burgrp/bleriot-relay/board/bleriot-relay.kicad_pcb

## KiCad design board/bleriot-relay.kicad_pcb (2026-11-08)

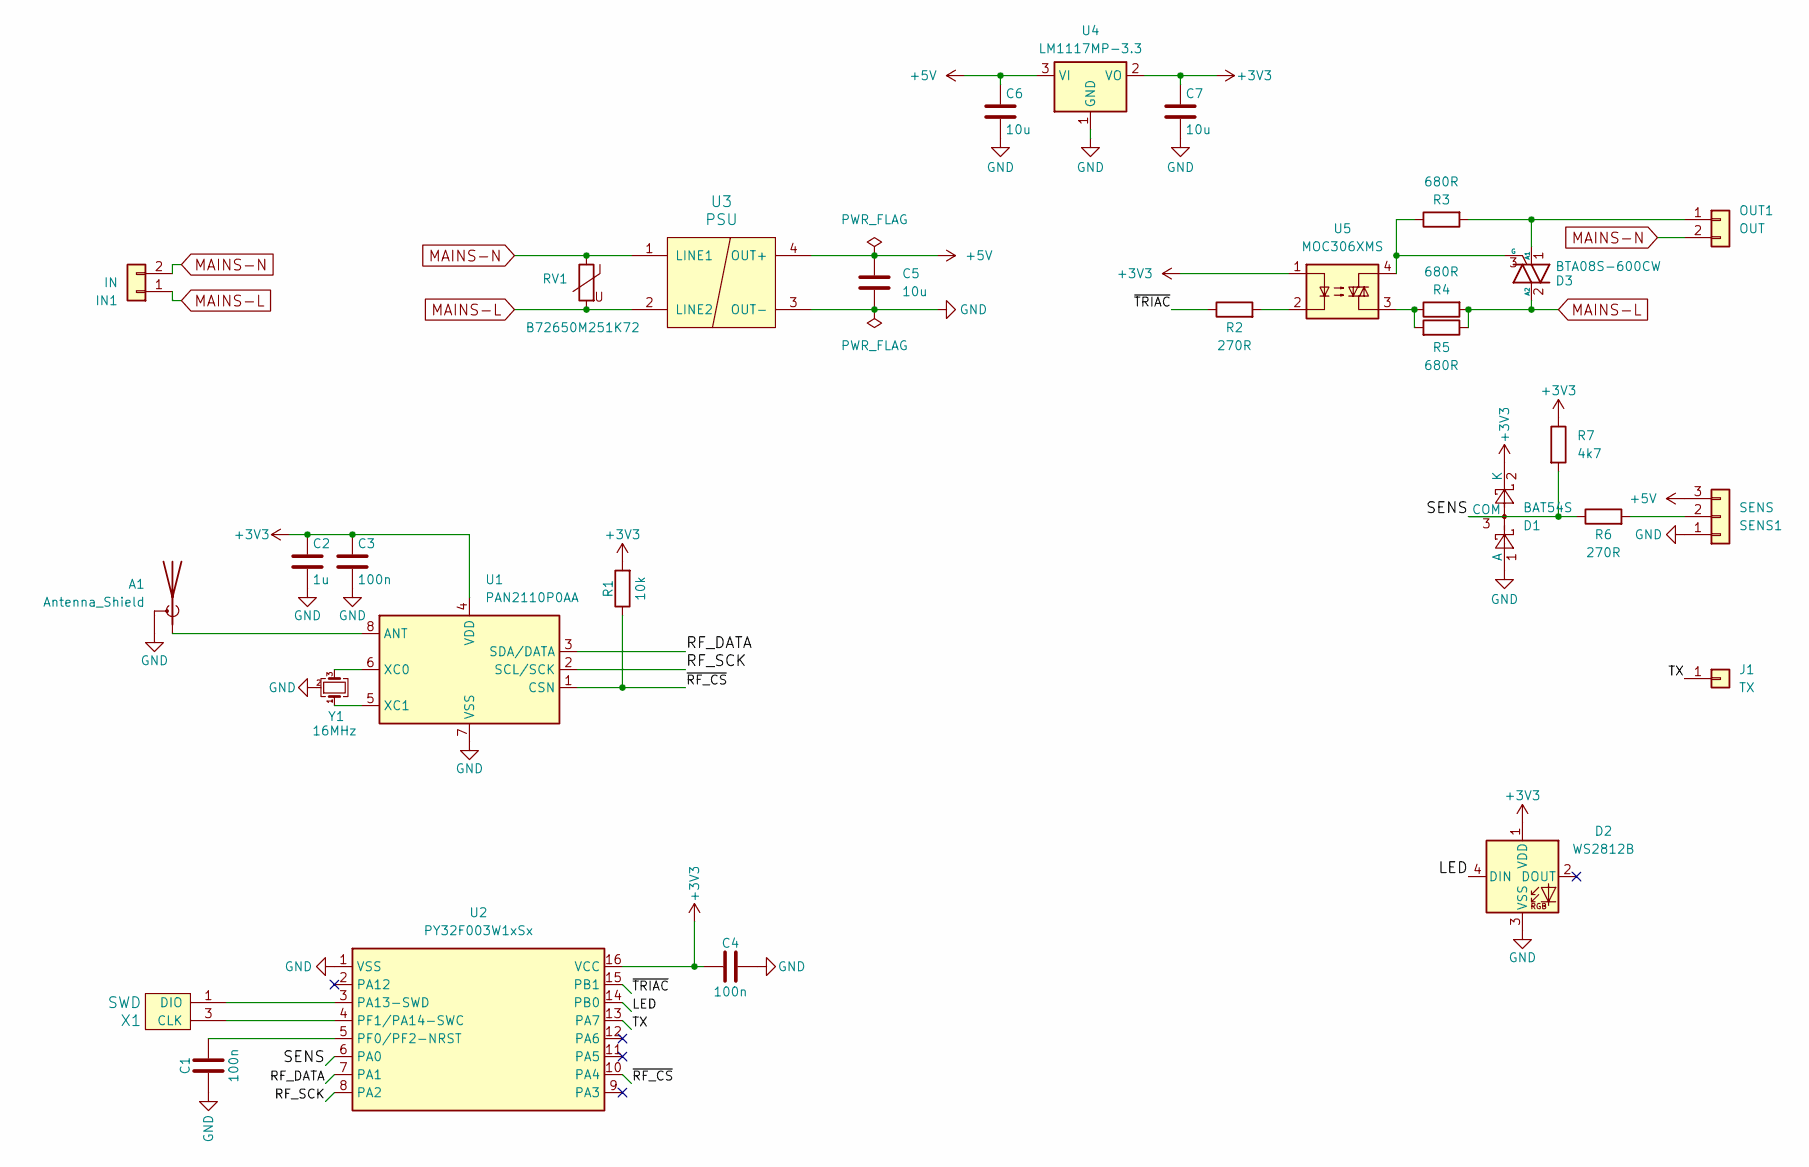
[picture p1: schematic bleriot-relay.kicad_sch]

Parts:
A1: Antenna_Shield; Texas_SWRA117D_2.4GHz_Right
C1, C3, C4: 100n; C_0805_2012Metric
C2: 1u; C_0805_2012Metric
C5, C6, C7: 10u; C_0805_2012Metric
D1: BAT54S; SOT-23
D2: WS2812B; LED_WS2812B_PLCC4_5.0x5.0mm_P3.2mm
D3: BTA08S-600CW; TO-252-2
IN1: IN; PhoenixContact_MSTBA_2,5_2-G_1x02_P5.00mm_Horizontal
J1: TX; PinHeader_1x01_P2.54mm_Vertical
OUT1: OUT; PhoenixContact_MSTBA_2,5_2-G_1x02_P5.00mm_Horizontal
R1: 10k; R_0805_2012Metric
R2, R6: 270R; R_0805_2012Metric
R3, R4, R5: 680R; R_0805_2012Metric
R7: 4k7; R_0805_2012Metric
RV1: B72650M251K72; R_1210_3225Metric
SENS1: SENS; PhoenixContact_MSTBA_2,5_3-G_1x03_P5.00mm_Horizontal
U1: PAN2110P0AA; SOIC-8_3.9x4.9mm_P1.27mm
U2: PY32F003W1xSx; SOIC-16_3.9x9.9mm_P1.27mm
U3: PSU; RQG 5V-0.6A-horizontal
U4: LM1117MP-3.3; SOT-223-3_TabPin2
U5: MOC306XMS; SMDIP-4_W7.62mm
X1: SWD
Y1: 16MHz; Crystal_SMD_3225-4Pin_3.2x2.5mm

Connections:
+3V3: C2.1, C3.1, C4.1, C7.1, D1.2 (K), D2.1 (VDD), R1.2, R7.1, U1.4 (VDD), U2.16 (VCC), U4.2 (VO), U5.1
+5V: C5.1, C6.1, SENS1.3, U3.4 (OUT+), U4.3 (VI)
/LED: D2.4 (DIN), U2.14 (PB0)
/RF_DATA: U1.3 (SDA/DATA), U2.7 (PA1)
/RF_SCK: U1.2 (SCL/SCK), U2.8 (PA2)
/SENS: D1.3 (COM), R6.1, R7.2, U2.6 (PA0)
/TX: J1.1 (Pin_1_1), U2.13 (PA7)
/~RF_CS: R1.1, U1.1 (CSN), U2.10 (PA4)
/~TRIAC: R2.1, U2.15 (PB1)
GND: A1.2 (Shield), C1.2, C2.2, C3.2, C4.2, C5.2, C6.2, C7.2, D1.1 (A), D2.3 (VSS), SENS1.1, U1.7 (VSS), U2.1 (VSS), U3.3 (OUT-), U4.1 (GND), X1.2 (GND), Y1.2 (G), Y1.4 (G)
MAINS-L: D3.2 (A2), IN1.1, R4.2, R5.1, RV1.2, U3.2 (LINE2)
MAINS-N: IN1.2, OUT1.2, RV1.1, U3.1 (LINE1)
unnamed: A1.1 (A), U1.8 (ANT)
unnamed: D3.1 (A1), OUT1.1, R3.2
unnamed: D3.3 (G), R3.1, U5.4
unnamed: R2.2, U5.2
unnamed: R4.1, R5.2, U5.3
unnamed: R6.2, SENS1.2
unnamed: U1.6 (XC0), Y1.3
unnamed: U1.5 (XC1), Y1.1
unnamed: U2.3 (PA13-SWD), X1.1 (DIO)
unnamed: C1.1, U2.5 (PF0/PF2-NRST)
unnamed: U2.4 (PF1/PA14-SWC), X1.3 (CLK)

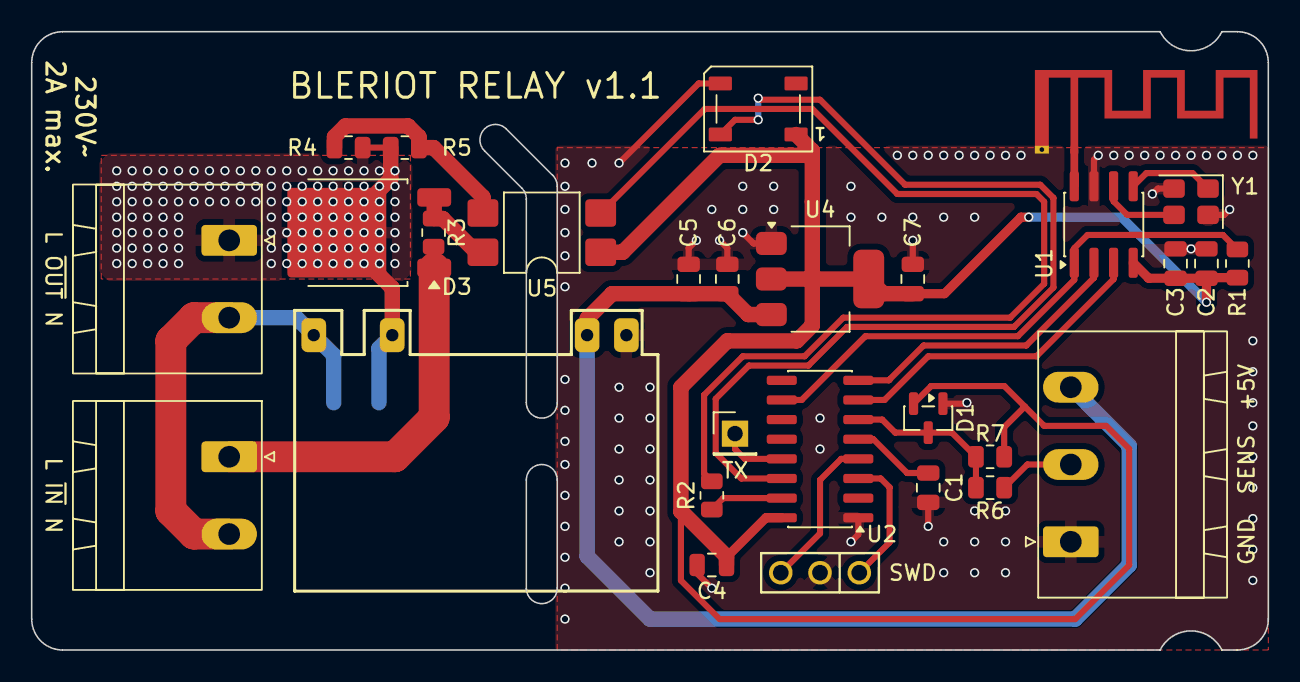
[picture p2: board bleriot-relay.kicad_pcb from above]

Board: 2 copper layers, 80.0 x 40.0 mm, 30 parts (1 on the bottom side), 23 nets.
