burgrp/bleriot-relay/(commit log)

2026-10-07 Refactor footprint coordinates for improved clarity and accuracy
    [bleriot-relay.kicad_pcb]
2026-11-08 Update used designators order and add version 1.1 notes to schematic
2026-11-08 Add relay firmware with optional watchdog and DS18B20 support
    Implement relay state, optional watchdog leases, DS18B20 register mapping, and matching fail-safe LED indications. Include the sensor pull-up schematic and updated PCB, with build configuration, tests, and documentation.
